illepidus/RTCS/arduino/README.md

# FAKE M-7054P
Поскольку поставка модуля M-7054P задерживается, пришлось на скорую руку сделать его клон c ограниченным функционалом на базе Arduino nano
* Выводы A0..A3 используются как дискретные выводы
* Поддерживаеся modbus-функция 0x15 [WRITE MULTIPLE COILS]
