illepidus/RTCS/doc/README.md

# Компоненты RTCS:
###### =====================================================
* Raspberri pi 4B = 1 шт.
* [Монитор с тач дисплеем 12"](https://aliexpress.ru/item/32974960577.html) = 1 шт.
* Модуль ввода с термосопротивлений M-7015P = 1 шт (6 датчиков)
* Модуль RS485-USB I-7563 = 1 шт.
* Модуль цифрового вывода M-7054PD : 1 шт.
###### =====================================================
* Корпус: DKC R5ST0553 500x500x300 = 1шт.
* Кронштейны для настенного крепления DKC R5A55 = 1 комплект.
* Кронштейн din-рейки TST20 = 10 шт.
###### ======================================================
* Din рейка Ω 35x7,5х1мм = 2м.
* Нулевая шина YNN10-69-12D-K07 = 4шт.
* Автоматический выключатель ABB S203 C32 = 1шт.
* Автоматический выключатель ABB S201 C6 = 5 шт.
###### ======================================================
* Блок питания: HDR-30-05 = 1шт.
* Блок питания  HDR-150-12 = 1шт.
###### ======================================================
* Термосопротивление: PT100 = 2 шт.
* Твердотельные реле: Fotek SSR-40-DA = 3 шт.
* Крепеж на дин-рейку SSR-S = 3 шт.
* Светозвуковой оповещатель Дуэт C-03С-220 = 1 шт.
###### =====================================================
