illepidus/RTCS/doc/ЩКТР.pdf

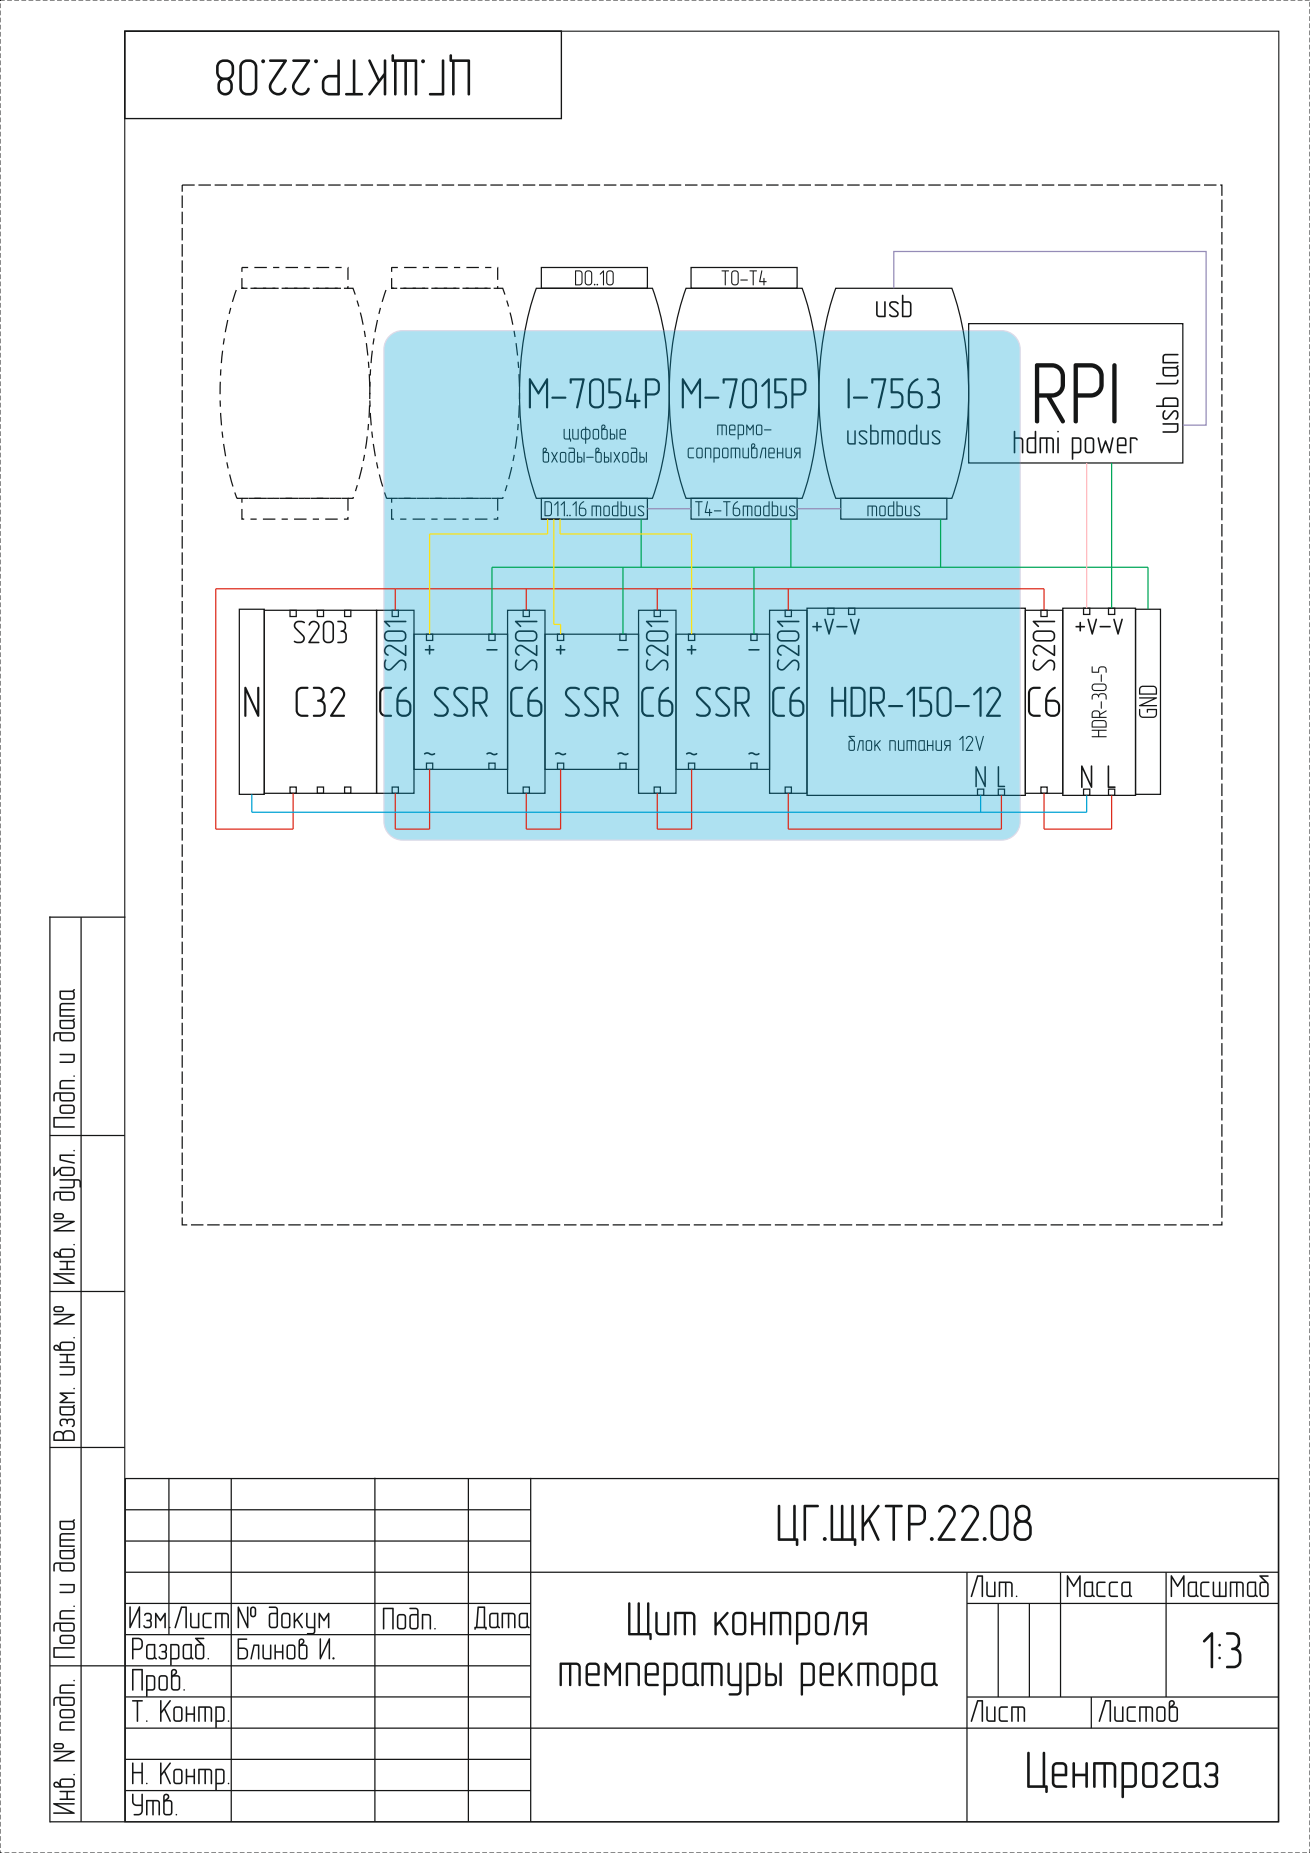
[picture p1: page 1]
