illepidus/RTCS/src/RTCS.h

#ifndef RTCS_H
#define RTCS_H

#include "global.h"
#include "RTCSMainWindow.h"
#include "PIDDevice.h"
#include "ModbusServerDevice.h"
#include "M7015Device.h"

#include <QObject>

class RTCS : public QObject
{
Q_OBJECT
private:
	RTCSMainWindow *main_window;
	PIDDevice *pid_heater;
	PIDDevice *pid_cooler;
	ModbusServerDevice *modbus_server;
	M7015Device *m7015p;
public:
	RTCS();
public slots:
	void showMainWindow(bool = true);
	void hideMainWindow();
};

#endif
