illepidus/RTCS/src/ModbusServerDevice.cpp

#include "ModbusServerDevice.h"

ModbusServerDevice::ModbusServerDevice(QString n, QObject *p) : Device(n, p)
{
	m_rtu = new QModbusRtuSerialMaster(this);
	loadSettings();

	start();
}

void ModbusServerDevice::loadSettings()
{
	QSettings s;
	m_portName = s.value(settingsKey("port_name"), "/dev/ttyUSB0").toString();
	m_parity   = static_cast<QSerialPort::Parity>   (s.value(settingsKey("parity"),    0     ).toInt());
	m_baudRate = static_cast<QSerialPort::BaudRate> (s.value(settingsKey("baud_rate"), 115200).toInt());
	m_dataBits = static_cast<QSerialPort::DataBits> (s.value(settingsKey("data_bits"), 8     ).toInt());
	m_stopBits = static_cast<QSerialPort::StopBits> (s.value(settingsKey("stop_bits"), 1     ).toInt());
	m_retries = (s.value(settingsKey("retries"), 3).toInt());
	m_timeout = (s.value(settingsKey("timeout"), 300).toInt());
}

void ModbusServerDevice::nextRequest()
{
	if (m_routineRequests.empty() && m_requests.empty()) {
		qDebug() << name() << "No requests to send. Waiting...";
		QTimer::singleShot(m_timeout, this, SLOT(nextRequest()));
		return;
	}

	if (!m_requests.empty()) {
		m_request = m_requests.takeFirst();
	}
	else {
		m_request = m_routineRequests.first();
		m_routineRequests.append(m_routineRequests.takeFirst());
	}

	QModbusReply *reply = m_rtu->sendRawRequest(m_request.request, m_request.address);

	if (!reply->isFinished()) {
		QObject::connect(reply, &QModbusReply::finished, this, &ModbusServerDevice::onReplyFinished);
	}
	else {
		delete reply;
		qWarning() << name() << "Received instant reply. Weird!";
		QTimer::singleShot(m_timeout, this, SLOT(nextRequest()));
	}
}

void ModbusServerDevice::onReplyFinished()
{
	auto reply = qobject_cast<QModbusReply *>(QObject::sender());
	if (!reply)
		return;

	if ((reply->error() == QModbusDevice::NoError) || (reply->error() == QModbusDevice::ProtocolError)) {
		const QModbusResponse response = reply->rawResult();
		QMetaObject::invokeMethod(m_request.device, "processResponse", Q_ARG(QModbusRequest, m_request.request), Q_ARG(QModbusResponse, response));
	}
	else {
		qCritical() << name() << "QModbusRtuSerialMaster error: " << reply->error();
	}

	reply->deleteLater();
	nextRequest();
}

bool ModbusServerDevice::addRoutineRequest(int address, QModbusRequest request, Device* device = nullptr) {
	m_routineRequests += Request(address, request, device);
	return true;
}

bool ModbusServerDevice::request(int address, QModbusRequest request, Device* device = nullptr) {
	m_requests += Request(address, request, device);
	return true;
}

bool ModbusServerDevice::start()
{
	if (stateFlag(Device::Disabled)) {
		qWarning() << name() << "Cannot start while disabled";
		return false;
	}

	if (stateFlag(Device::Running)) {
		qWarning() << name() << "Cannot start while running";
		return false;
	}

	m_rtu->setConnectionParameter(QModbusDevice::SerialPortNameParameter, m_portName);
	m_rtu->setConnectionParameter(QModbusDevice::SerialParityParameter,   m_parity);
	m_rtu->setConnectionParameter(QModbusDevice::SerialBaudRateParameter, m_baudRate);
	m_rtu->setConnectionParameter(QModbusDevice::SerialDataBitsParameter, m_dataBits);
	m_rtu->setConnectionParameter(QModbusDevice::SerialStopBitsParameter, m_stopBits);
	m_rtu->setTimeout(m_timeout);
	m_rtu->setNumberOfRetries(m_retries);

	if (m_rtu->connectDevice()) {
		setStateFlag(Device::Running, true);
		qInfo() << name() << "Connected to serial port";
		nextRequest();
		return true;
	}
	qCritical() << name() << "Was not able to connect to serial port";
	return false;
}

bool ModbusServerDevice::stop()
{
	if (stateFlag(Device::Disabled)) {
		qWarning() << name() << "Cannot stop while disabled";
		return false;
	}
	if (!stateFlag(Device::Running)) {
		qWarning() << name() << "Cannot stop while running";
		return false;
	}

	setStateFlag(Device::Running, false);
	m_rtu->disconnectDevice();
	return true;
}
