illepidus/RTCS/(commit log)

2022-09-02 PID, Settings class introduced
2022-09-25 introducing FAKE M7054P arduino-based device
